qorhvma/HexaCore/firmware/myFirmware/readme.md

# 할일
[*] 모터 제어
[ ] 버튼, imu 상태 전송
[*] 블루투스 읽기 비동기화 
[*] UART 통신
