qorhvma/HexaCore/learning/docs/plan.md

# 학습 계획
- Teacher A(걷기): 속도 + 몸통 높이 command
- Teacher B(계단 160mm): phase 보상, 높이 command 고정(높게), phase별 상태 저장 리셋
- Student(통합): 라이다 높이맵 + 고유감각, env별 A/B를 모방해 증류

# 구체적인 해야 할 일
- phase init state 버퍼 초기 자세 생성(+검증)
- student 관측 시험: [student_observation_test.md](student_observation_test.md)
