qorhvma/HexaCore/docs/build/parts.md

# 1. 부품 구매

## 부품 목록

원본: [`hardware/bom/BOM.csv`](repo:hardware/bom/BOM.csv). *상태* 열이 "확정"이 아닌 항목은 아직 정하는 중입니다.

{{ bom }}

- 가격은 팀이 실제로 산 값을 추산한 것입니다. 지금까지 확인된 합계는 약 89만원이고, 빈 칸 부품은 들어 있지 않습니다.
- 전원은 유선(12 V SMPS)과 배터리 중 하나를 고릅니다. 어느 쪽이든 XL4016 강압 컨버터 2개로 서보용 6 V 레일 2개를 만듭니다.

## 필요한 공구

- 3D 프린터: 출력 면적 **235 × 230 mm 이상** (몸통 판 때문)
- 납땜 인두, 땜납 (PCB와 배선)
- 드라이버, 니퍼, 와이어 스트리퍼
- 멀티미터 (컨버터 출력 전압 맞추기)
- USB 케이블 (ESP32 펌웨어 올리기, 라즈베리파이 연결)
