qorhvma/HexaCore/hardware/bom/BOM.csv

분류 | 부품 | 수량 | 사양·비고 | 가격(원) | 상태
구동 | MG996R 서보 | 6 | coxa 관절. CAD 이름 mg996r | 360,000 (서보 18개 합계) | 확정
구동 | RC9 서보 | 12 | femur·tibia 관절. CAD 이름 rc9mg | (위에 포함) | 확정
구동 | 서보 혼 | 18 | 서보 동봉품. CAD 이름 motorhorn | (서보 포함) | 확정
제어 | Raspberry Pi 5 | 1 | 상위 제어·라이다·WebSocket 서버 | 200,000 | 확정
제어 | ESP32 개발보드 | 1 | 실시간 서보 제어. 사용 핀: I2C 21/22, 32/33, 발 스위치 4·16·17·5·18·19 |  | 가격 확인 필요
제어 | HexaCore 제어 PCB | 1 | 자체 설계 원형 2층 기판. 거버: ../pcb/gerber/Gerber_PCB1.zip |  | 가격 확인 필요
제어 | PCA9685 16채널 PWM 드라이버 | 2 | I2C 주소 0x40·0x41. 제어 PCB에 장착 |  | 가격·형태(IC/모듈) 확인 필요
센서 | Unitree L2 4D 라이다 | 1 | UDP 6101/6201 | 300,000 | 확정
센서 | BNO086 IMU 보드 | 1 | I2C 0x4A(Adafruit) 또는 0x4B(SparkFun), SDA 32 / SCL 33 |  | 가격 확인 필요
센서 | 발 접촉 스위치 | 6 | 한쪽 GPIO, 한쪽 GND (내부 풀업) |  | 종류·가격 확인 필요
전원 | 강압 컨버터 XL4016 | 2 | 6 V 서보 레일 2개. CAD 이름 hw674로 추정 |  | 확인 필요
전원 | 12 V 250 W SMPS | 1 | 유선 전원 |  | 전원 방식 확인 필요
전원 | 배터리 | 1 | CAD 이름 battery (110 × 34 × 32 mm). 셀 수(3S/4S) 미정 |  | 전원 방식 확인 필요
프레임 | 3D 프린팅 부품 | 10종 51개 | ../cad/stl/ 참고. 꽉 찬 부피 합 약 640 cm³ | 30,000 | 확정
기타 | 볼트·너트·배선·커넥터 |  |  |  | 목록 작성 필요
