qorhvma/HexaCore/hardware/cad/stl/mainbody.stl

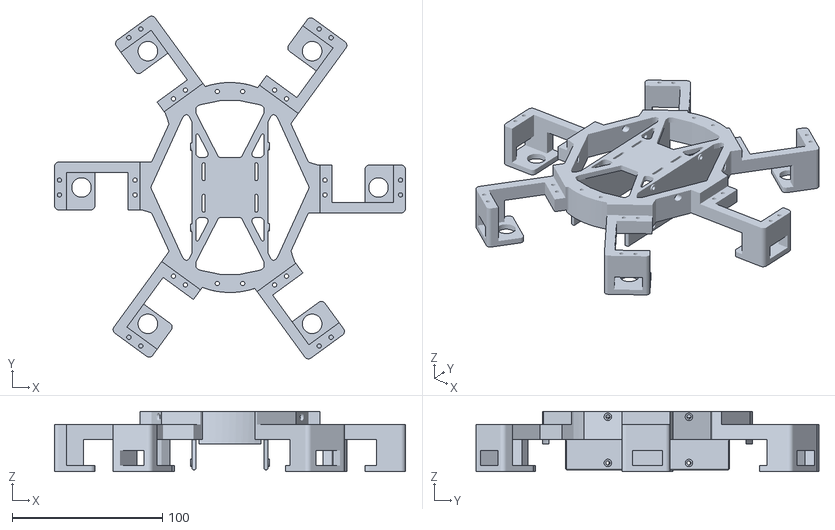
[picture p4: CAD file, 2026-11-07]
hardware/cad/stl/mainbody.stl
234.0 x 228.5 x 40.0
