qorhvma/HexaCore/learning/src/RLforHexapod/assets/assets/mainbody.stl

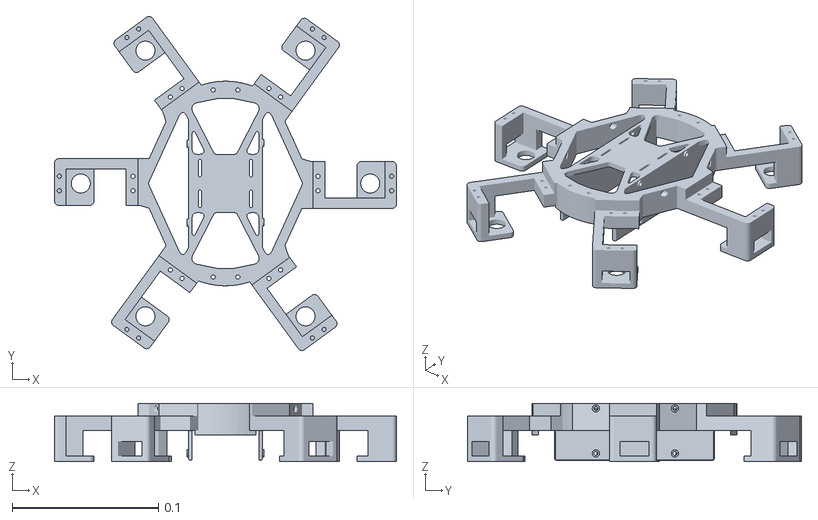
[picture p5: CAD file, 2026-11-06]
learning/src/RLforHexapod/assets/assets/mainbody.stl
0.234 x 0.228 x 0.04
