qorhvma/HexaCore/hardware/cad/stl/batterycover.stl

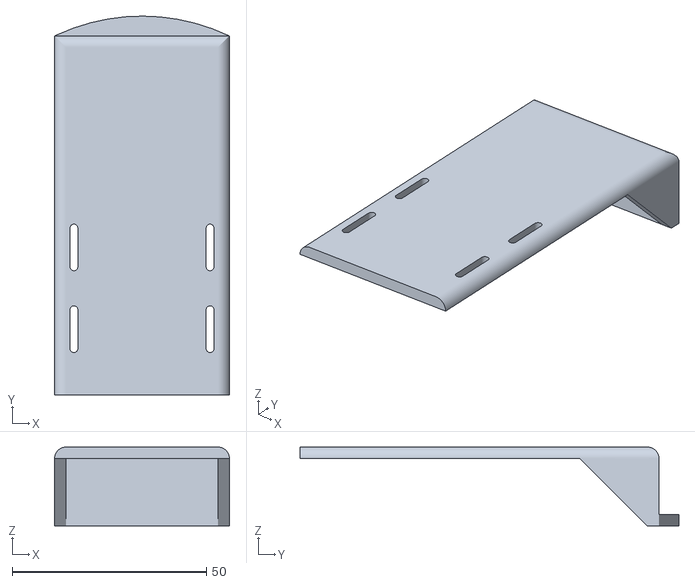
[picture p6: CAD file, 2026-11-07]
hardware/cad/stl/batterycover.stl
45.0 x 97.4 x 20.3
