qorhvma/HexaCore/learning/src/RLforHexapod/assets/assets/mg996r.stl

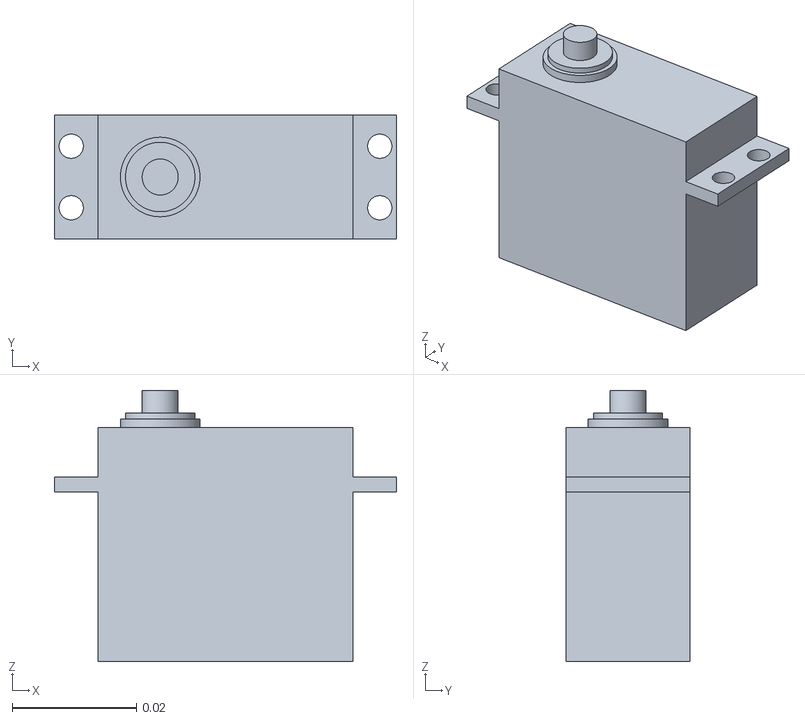
[picture p7: CAD file, 2026-11-06]
learning/src/RLforHexapod/assets/assets/mg996r.stl
0.055 x 0.02 x 0.0436
