qorhvma/HexaCore/learning/src/RLforHexapod/assets/assets/jointcover.stl

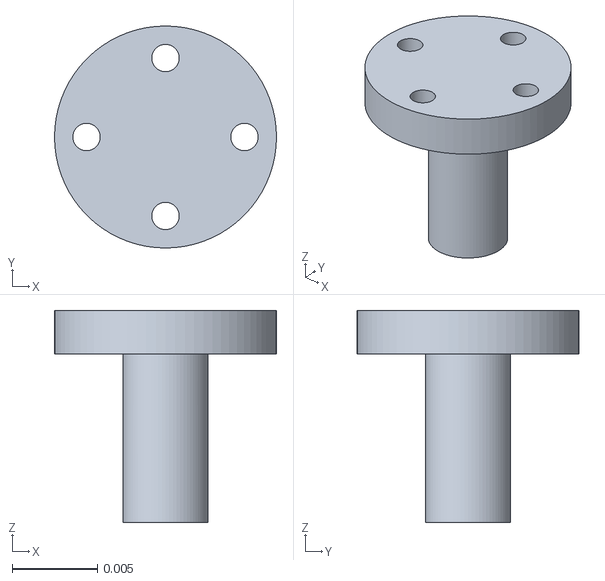
[picture p8: CAD file, 2026-11-06]
learning/src/RLforHexapod/assets/assets/jointcover.stl
0.013 x 0.013 x 0.0124
