qorhvma/HexaCore/hardware/cad/stl/femur.stl

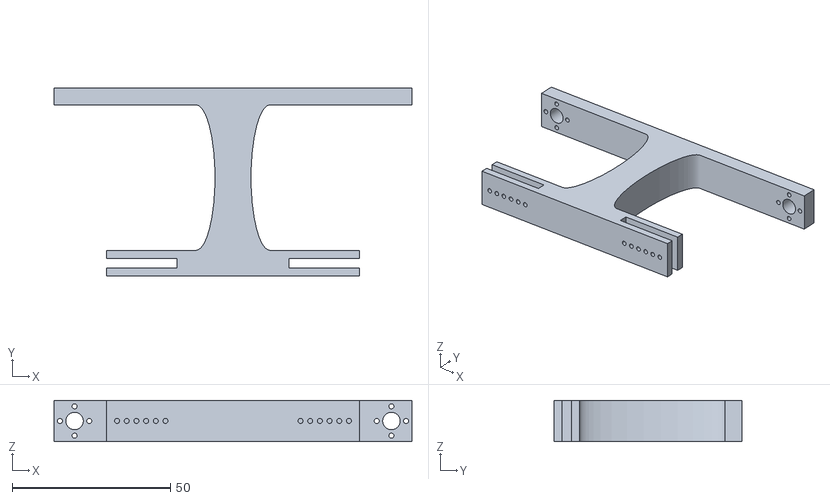
[picture p9: CAD file, 2026-11-07]
hardware/cad/stl/femur.stl
113.0 x 59.4 x 13.0
