qorhvma/HexaCore/learning/src/RLforHexapod/assets/assets/coxajoint.stl

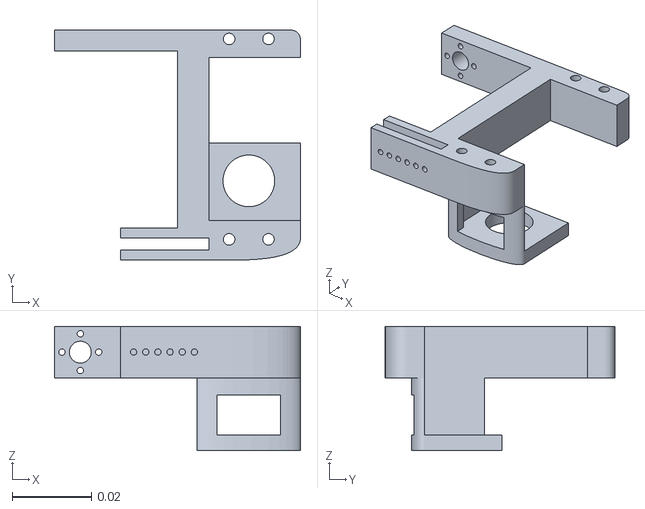
[picture p10: CAD file, 2026-11-06]
learning/src/RLforHexapod/assets/assets/coxajoint.stl
0.0619 x 0.058 x 0.0313
