qorhvma/HexaCore/hardware/cad/stl/tibiatip1.stl

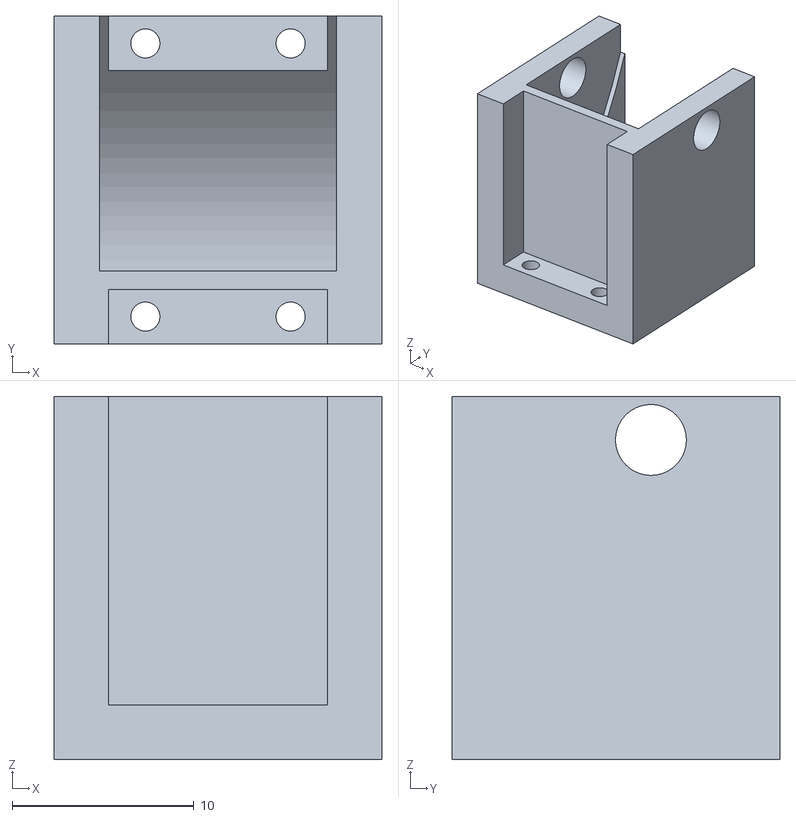
[picture p11: CAD file, 2026-11-07]
hardware/cad/stl/tibiatip1.stl
18.0 x 18.0 x 20.0
