qorhvma/HexaCore/learning/src/RLforHexapod/assets/assets/tibiatip3.stl

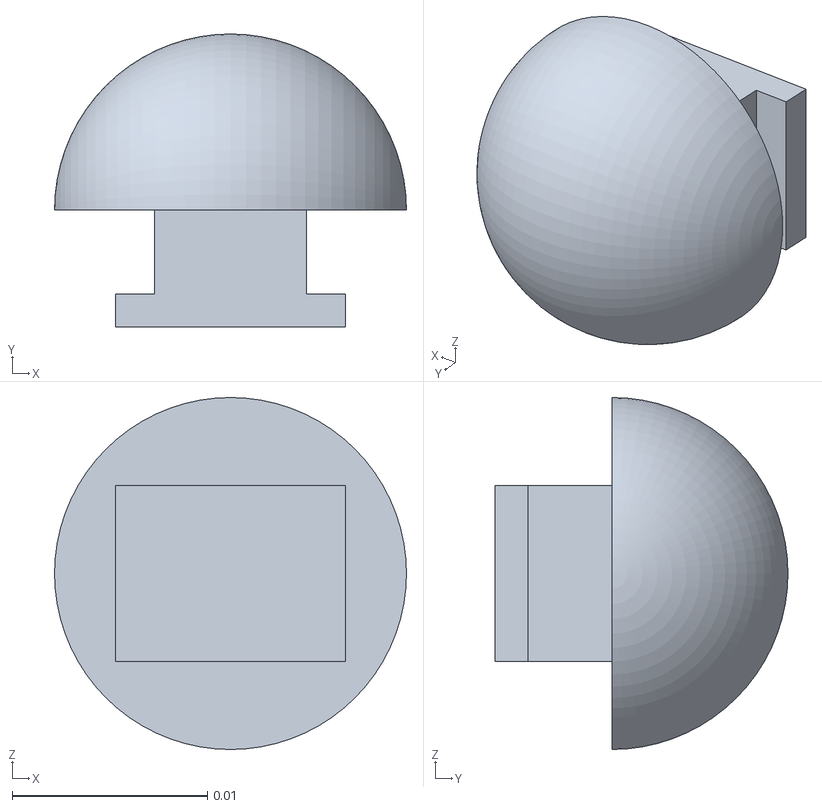
[picture p12: CAD file, 2026-11-06]
learning/src/RLforHexapod/assets/assets/tibiatip3.stl
0.018 x 0.015 x 0.0181
