qorhvma/HexaCore/hardware/cad/stl/tibiatip3.stl

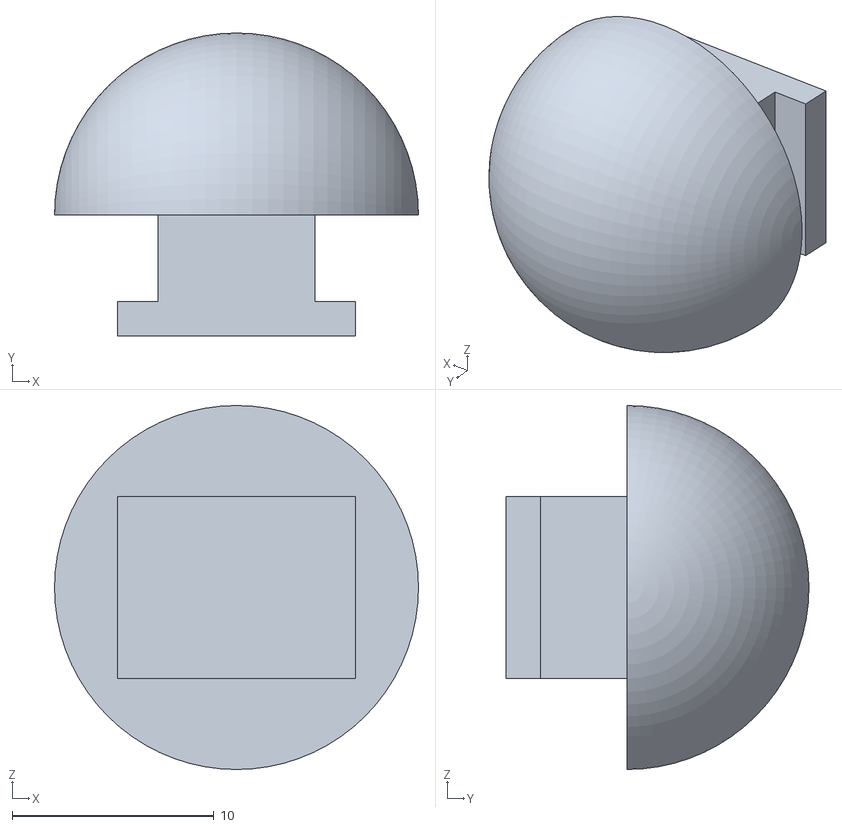
[picture p13: CAD file, 2026-11-07]
hardware/cad/stl/tibiatip3.stl
18.0 x 15.0 x 18.0
