qorhvma/HexaCore/learning/src/RLforHexapod/assets/assets/tibia.stl

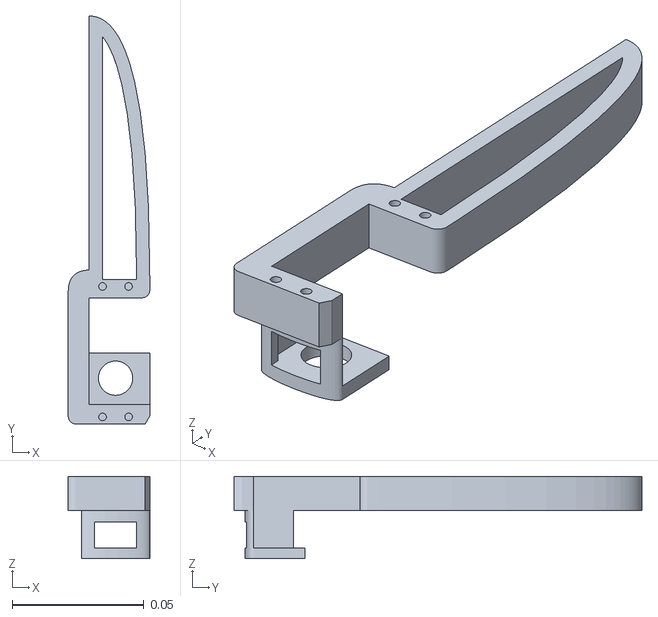
[picture p14: CAD file, 2026-11-06]
learning/src/RLforHexapod/assets/assets/tibia.stl
0.031 x 0.155 x 0.0313
