qorhvma/HexaCore/hardware/cad/stl/coxajoint.stl

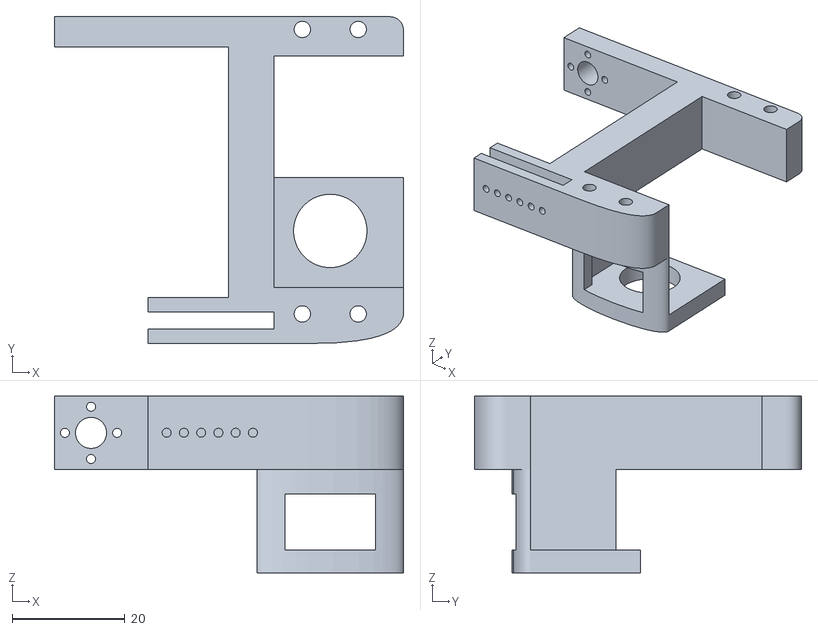
[picture p15: CAD file, 2026-11-07]
hardware/cad/stl/coxajoint.stl
61.9 x 58.0 x 31.3
