qorhvma/HexaCore/learning/src/RLforHexapod/assets/assets/tibiatip2.stl

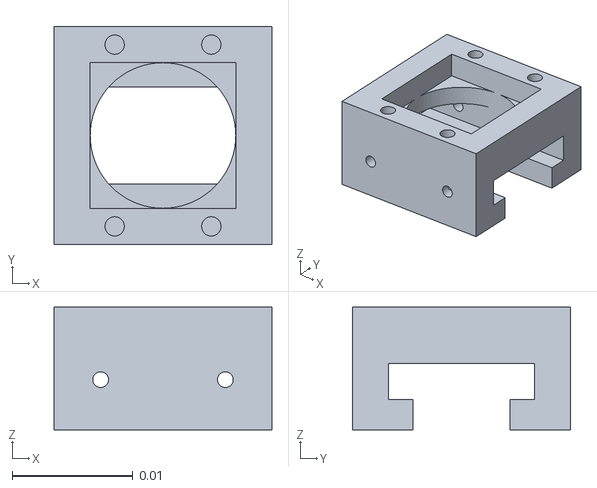
[picture p16: CAD file, 2026-11-06]
learning/src/RLforHexapod/assets/assets/tibiatip2.stl
0.0181 x 0.0181 x 0.0101
