qorhvma/HexaCore/hardware/cad/stl/tibiatip2.stl

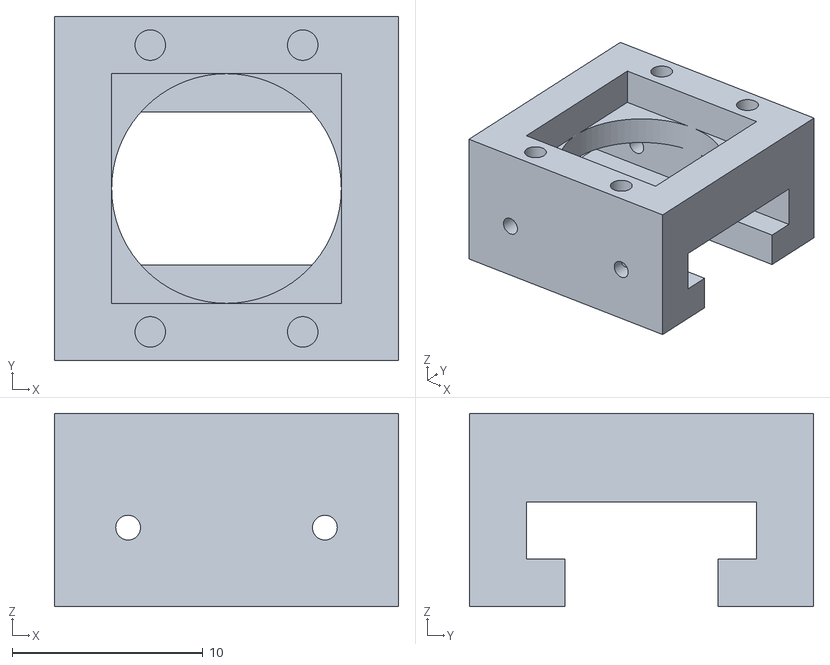
[picture p17: CAD file, 2026-11-07]
hardware/cad/stl/tibiatip2.stl
18.0 x 18.0 x 10.1
