qorhvma/HexaCore/learning/src/RLforHexapod/assets/assets/battery.stl

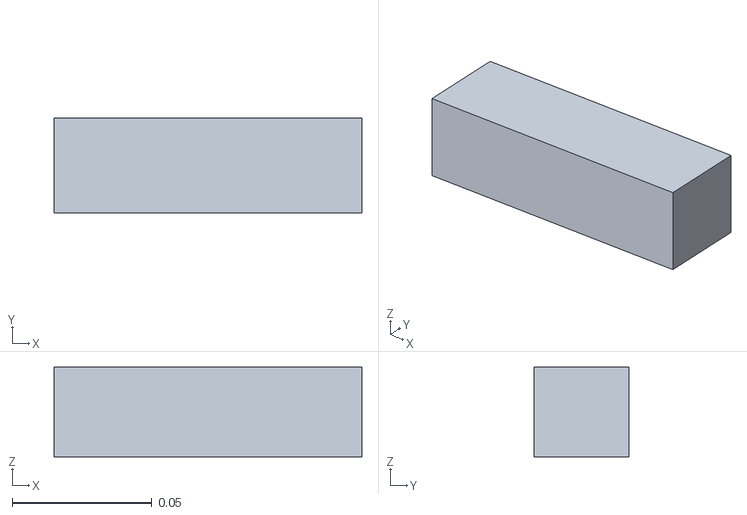
[picture p18: CAD file, 2026-11-06]
learning/src/RLforHexapod/assets/assets/battery.stl
0.11 x 0.034 x 0.032
