qorhvma/HexaCore/hardware/cad/stl/jointcover.stl

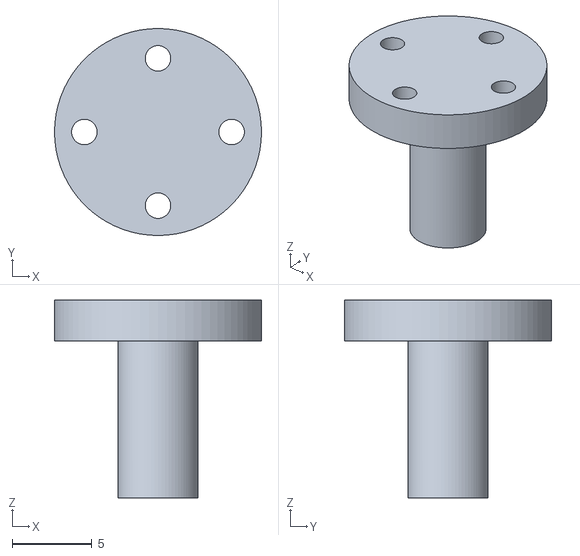
[picture p19: CAD file, 2026-11-07]
hardware/cad/stl/jointcover.stl
13.0 x 13.0 x 12.4
