qorhvma/HexaCore/learning/src/RLforHexapod/assets/assets/tibiatip1.stl

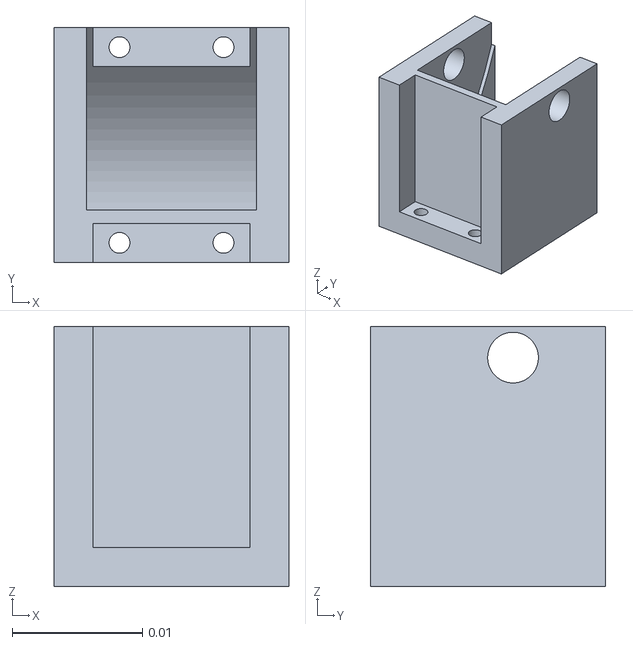
[picture p20: CAD file, 2026-11-06]
learning/src/RLforHexapod/assets/assets/tibiatip1.stl
0.0181 x 0.0181 x 0.02
