qorhvma/HexaCore/hardware/cad/stl/bodytop.stl

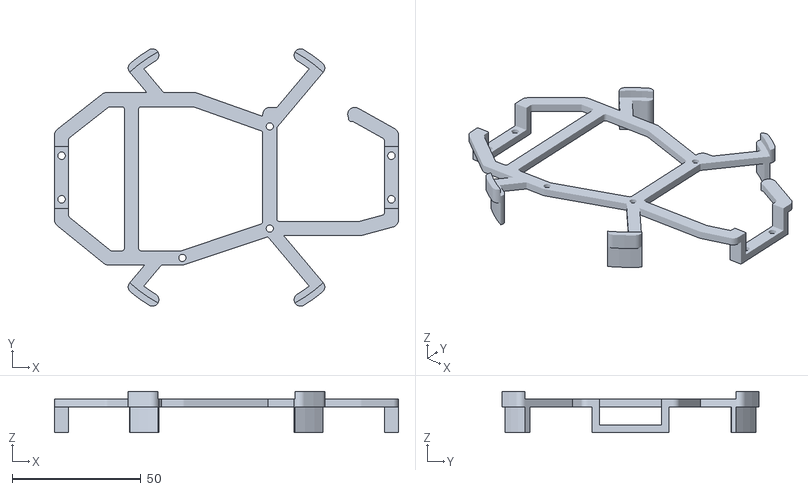
[picture p21: CAD file, 2026-11-07]
hardware/cad/stl/bodytop.stl
133.6 x 99.9 x 16.0
