qorhvma/HexaCore/hardware/cad/stl/tibia.stl

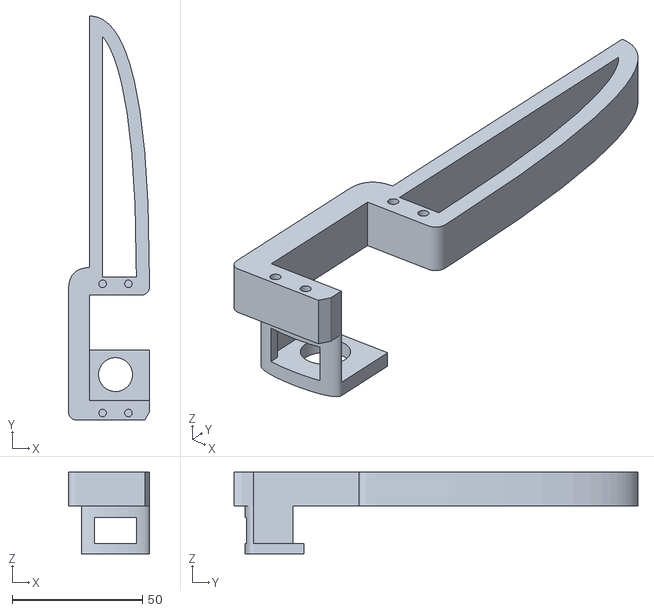
[picture p22: CAD file, 2026-11-07]
hardware/cad/stl/tibia.stl
31.0 x 154.9 x 31.3
