qorhvma/HexaCore/learning/src/RLforHexapod/assets/assets/bodytop.stl

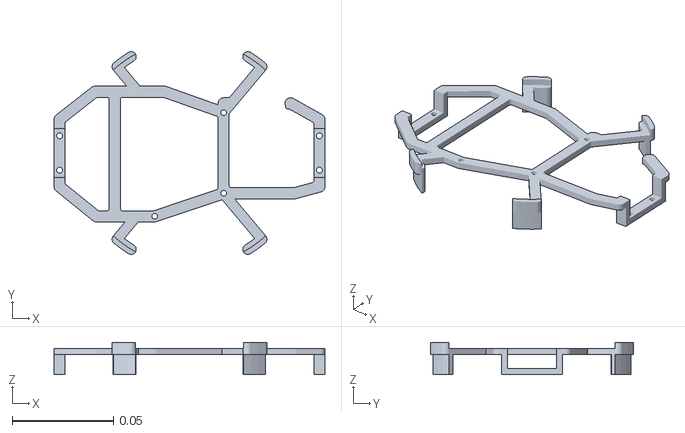
[picture p23: CAD file, 2026-11-06]
learning/src/RLforHexapod/assets/assets/bodytop.stl
0.134 x 0.0999 x 0.016
