qorhvma/HexaCore/learning/src/RLforHexapod/assets/assets/batterycover.stl

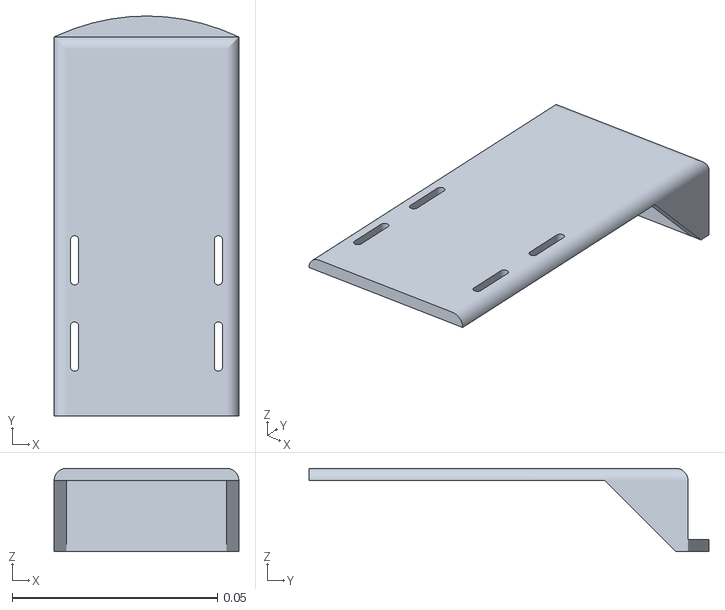
[picture p24: CAD file, 2026-11-06]
learning/src/RLforHexapod/assets/assets/batterycover.stl
0.045 x 0.0974 x 0.0203
