qorhvma/HexaCore/learning/src/RLforHexapod/assets/assets/motorhorn.stl

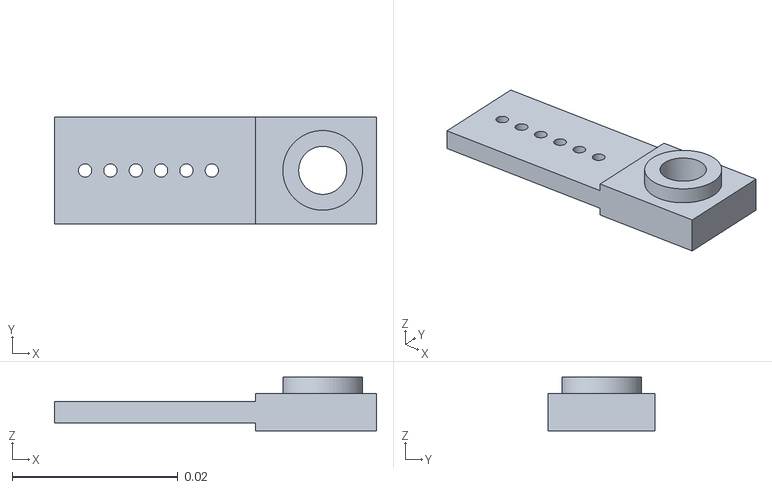
[picture p25: CAD file, 2026-11-06]
learning/src/RLforHexapod/assets/assets/motorhorn.stl
0.0389 x 0.013 x 0.00648
