qorhvma/HexaCore/learning/src/RLforHexapod/assets/assets/hw674.stl

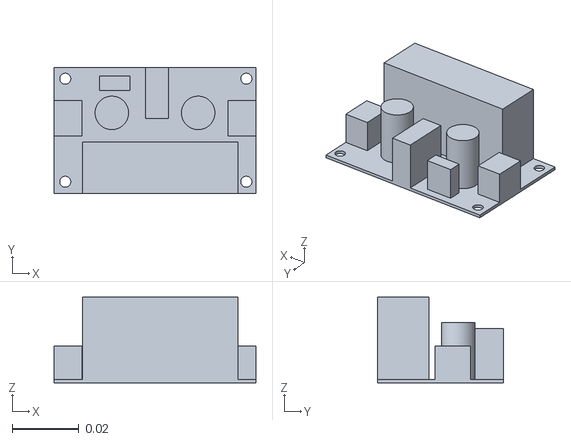
[picture p26: CAD file, 2026-11-06]
learning/src/RLforHexapod/assets/assets/hw674.stl
0.0603 x 0.0377 x 0.0256
