qorhvma/HexaCore/learning/src/RLforHexapod/assets/assets/femur.stl

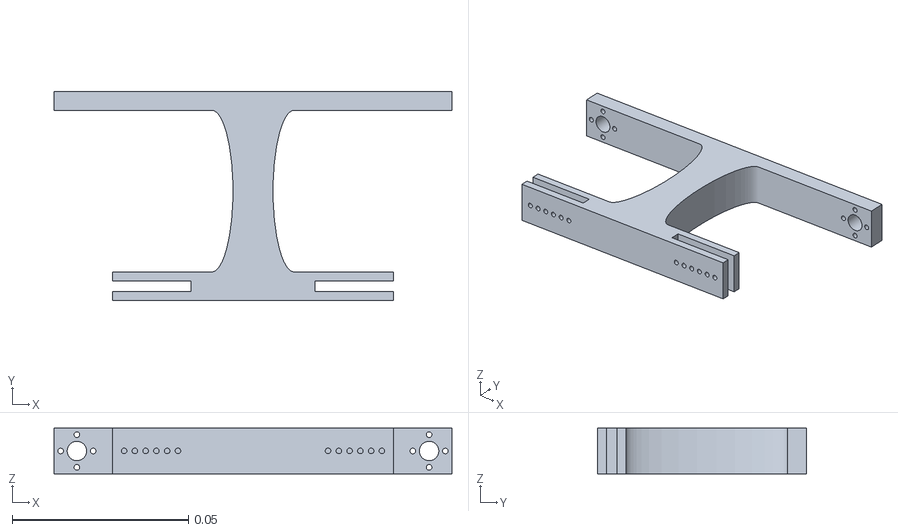
[picture p27: CAD file, 2026-11-06]
learning/src/RLforHexapod/assets/assets/femur.stl
0.113 x 0.0594 x 0.013
