qorhvma/HexaCore/learning/src/RLforHexapod/assets/assets/rc9mg.stl

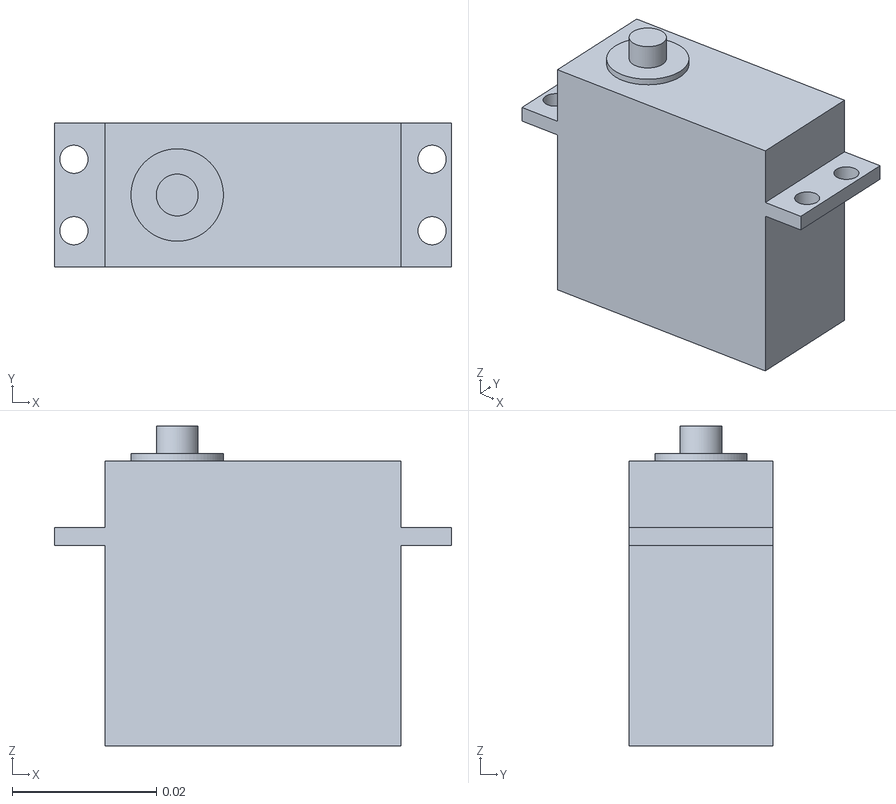
[picture p28: CAD file, 2026-11-06]
learning/src/RLforHexapod/assets/assets/rc9mg.stl
0.055 x 0.02 x 0.0443
