qorhvma/HexaCore/docs/build/operate.md

# 8. 조종

## 키보드 조종

PC에서:

```bash
python3 software/pc/pc_client.py --host <라즈베리파이 IP>
```

라즈베리파이 프로그램을 `--sim`으로 PC에서 돌렸다면 `--host localhost`입니다.

| 키 | 동작 |
|---|---|
| `w` / `s` | 앞 / 뒤 |
| `a` / `d` | 왼쪽 / 오른쪽 옆걸음 |
| `q` / `e` | 제자리 회전 |
| `space` | 정지 |
| `t` | 서기 |
| `o` | 힘 빼기 |
| `x` | 비상정지 |
| `z` | IMU 수평 기억 |
| `l` | 라이다 켜기 / 끄기 |
| `r` / `m` | 지도 초기화 / 저장 (라즈베리파이의 `maps/`) |

최고 속도는 앞뒤 0.12 m/s, 옆 0.08 m/s, 회전 0.6 rad/s입니다.

## 대시보드

브라우저로 [`software/dashboard/index.html`](repo:software/dashboard/index.html)을 열고 위쪽에 `ws://<라즈베리파이 IP>:8765`를 넣으면 지도와 센서 값이 보입니다.
주소 뒤에 `?ws=ws://localhost:8765`를 붙여 열어도 됩니다. 연결이 안 되면 브라우저 안 데모 모드로 돕니다.

## 안전 정지

| 상황 | 동작 |
|---|---|
| 조종 명령이 0.5초 끊김 | 라즈베리파이가 걸음을 멈추고 섬 |
| 몸이 25°보다 기욺 | 걸음을 멈추고 섬 |
| 라즈베리파이 ↔ ESP32 연결 끊김 | **아직 없음** — 서보가 마지막 자세를 유지 ([5단계](firmware.md#시리얼-명령)) |
| `x` (비상정지) | **서보 힘을 뺌** — 로봇이 주저앉습니다 |

!!! warning
    비상정지는 서보 힘을 빼는 것이라 계단 위에서 누르면 로봇이 떨어질 수 있습니다. 계단에서는 `space`(정지)를 먼저 쓰세요.
