qorhvma/HexaCore/(commit log)

2026-11-06 Initial open-source release of HexaCore
    Low-cost stair-climbing hexapod: ESP32 firmware and servo tools,
    Raspberry Pi node, PC client and dashboard, Isaac Lab 3.0 training
    environment (walk, stair teacher, student distillation), PCB Gerber,
    servo measurement data, kinematics tools and legacy rule-based code.
    Licenses: code MIT, hardware CERN-OHL-P-2.0, data/docs CC BY 4.0.
    [battery.stl, batterycover.stl, bodytop.stl, coxajoint.stl, femur.stl, hw674.stl, jointcover.stl, mainbody.stl]
2026-11-07 Add hardware publication: BOM, printable STLs, PCB pinout
    - hardware/bom/BOM.csv: parts, quantities, known prices, open items
    - hardware/cad/stl/: 10 printed parts converted to mm (51 pieces total)
    - tools/cad/export_print_stl.py: regenerate STLs from the sim meshes
    - hardware/pcb/README.md: board size, ordering, ESP32 pin map, servo channels
    - hardware/README.md: Onshape CAD link, print notes, what is still missing
    [BOM.csv, batterycover.stl, bodytop.stl, coxajoint.stl, femur.stl, jointcover.stl, mainbody.stl, tibia.stl]
2026-11-07 Add MkDocs build guide and GitHub Pages deployment
    - docs/: 8-step build guide (parts, printing, PCB, assembly, firmware,
    calibration, Raspberry Pi, operation) and reference pages
    - tools/docs/hooks.py: repo: links and the BOM table follow mkdocs.yml
    repo_url and hardware/bom/BOM.csv, so they are written in one place
    - .github/workflows/docs.yml: build with --strict and deploy to Pages
    - README: link the guide; fix the stop-on-signal-loss claim (the 0.5 s
    stop is on the Raspberry Pi; the ESP32 firmware has none yet)
2026-11-13 캘리브레이션 표(data/calibration)로 IK 보행 보정
    - data/calibration/calibration.json: firmware.ino(SV·JOINT_OFS·틱 한계), hexapod_sdk.py(다리 길이·관절 범위·부호·서기 자세),
    hexapod_pose_gui.py(관절 보정: 가변저항 곡선·일자 자세·SLIDER_PER_90), CAD 다리 위치를 한 표로
    - check_calibration.py: 원본에서 표 생성(--update)과 대조
    - leg_model.py: 표만 읽음. 실제 관절 각도 → 펌웨어 각도 변환(to_firmware = calibrated_joint)
    - ik_gait.py: 실제 각도로 계산하고 보낼 때 보정 적용. robot_main 서기 명령도 보정된 자세
    - gait_check.py: 표·원본 대조, 틱 한계 검사, --identify 보정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
2026-11-13 robot_main: 노드 버전·보행 종류·코드 위치를 시작 로그와 hello 에 표시 (v0.4.0-pi)
    예전 노드(보정 없음)가 떠 있는지 조종기 쪽에서 바로 알 수 있게 한다.
    시작할 때 캘리브레이션 표 경로와 보정된 서기 자세(펌웨어 각도)도 출력한다.
2026-11-13 firmware/tools/pi_upload.sh: 파이에서 ESP32 컴파일·업로드 (ttyAMA0, GPIO23=EN, GPIO24=BOOT)
    ttyAMA0 에는 DTR/RTS 가 없어 esptool 이 업로드 모드로 못 바꾸므로 pinctrl 로 EN/BOOT 를 직접 제어한다.
    robot_main.py 가 포트를 쓰고 있으면 끄고, 끝나면 GPIO 를 입력+풀업으로 돌려 놓는다. --reset 은 리셋만.
2026-11-13 pi_upload.sh: pinctrl 에 인자를 따로 넘김 ("op dl" 한 덩어리 → Unknown argument)
2026-11-13 pi_upload.sh: pinctrl 만 sudo 로, arduino-cli 위치 찾기, ESP32 코어 확인
    - 이 파이는 pinctrl 에 root 가 필요 ("Must be root") → 스크립트는 사용자로 돌리고 pinctrl 만 sudo
    - sudo 로 전체를 돌리면 root 의 arduino-cli 설정을 써서 보드 패키지를 못 찾으므로 멈추고 안내
    - arduino-cli 를 PATH, ~/.local/bin, ~/bin, Arduino IDE 2 안에서 찾음. esp32:esp32 가 없으면 설치 명령 안내
2026-11-13 pi_upload.sh: NOPASSWD 계정에서 비밀번호를 묻지 않게
    sudo -v 는 비밀번호가 필요한 규칙(%sudo ALL)이 하나라도 있으면 NOPASSWD 규칙이 있어도 비밀번호를
    묻는다. 비밀번호가 없는 hexa 계정에서는 인증에 실패했다. 먼저 sudo -n true 로 확인하고, 안 될 때만 sudo -v.
2026-11-13 보행: 측정점 임시 끄기(HEXAPOD_JOINT_POINTS=0), 걸을 수 없을 때 이유 경고
    다리 2·3 tibia 가 ① 측정 1점 + 예전 기울기로 계산돼 서기 자세가 서보 끝에 붙어 보폭이 0mm 였다.
    - leg_model: HEXAPOD_JOINT_POINTS=0 이면 측정점을 무시하고 pose_gui 보정만. stand_margins() 로 여유 없는 관절을 찾음
    - ik_gait.walk_warning(): 보폭이 30mm 미만이면 어느 다리·관절 때문인지와 해결책
    - robot_main 시작 로그, gait_check 에 보폭·경고 표시 (gait_check 는 걸을 수 없으면 실패)
